kirchberger/WFR-24E_ECU/README.md

# WFR-24E_ECU

In the WFR-24E FSAE car, this device reads all sensor and controls all parts of the WFR-24E.

We decided to have 2 controllers onboared to reduce wiring from front to back of the car.
This significantly reduces the harness complexity in the car.
The car has a 24V low voltage system so the input voltage range of the device must accomadate this, and the device must interface with all sensors and outputs.

Sensors were primarally analog with a few digital buttons.
Motor inverter and BMS were communicated over CAN with a couple lights requiring switched power outputs.
Switched poer is performed with a high side driver.

The final interfaces chosen for the device were:
| Interface | Number |
| :--- | :----- |
| CANBUS | 2 |
| 5V Analog Inputs | 18 |
| 5V IO | 4 |
| 9-36V 3A Switched Power | 8 |
| 5V 0.5A Sensor Supply | 1 |

More analog inputs were chosen for possible expansion of our sensor system.

This device also included reverse voltage protection and a PTC self resetable fuse on the sensor 5V supply.

This was able to be designed with a small sealed form factor based on a Teensy 4.1 for reduced scope.
Box was not included in images.

Image of Assembled Device:

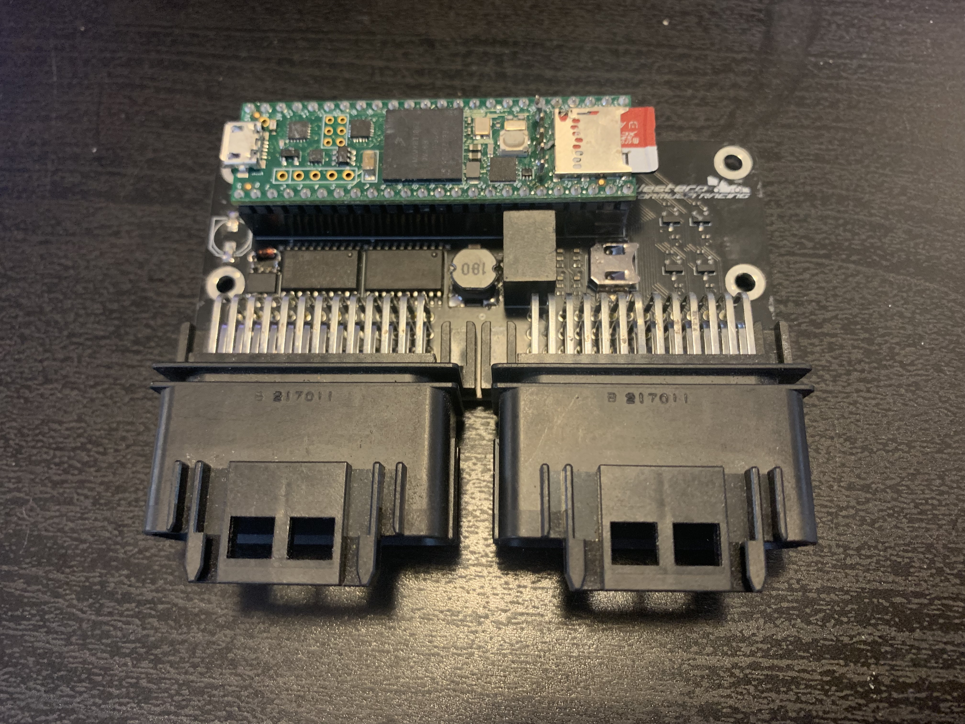
[picture p1: WFR-24E_ECU_Device.jpg]


Image of Inputs Schematic

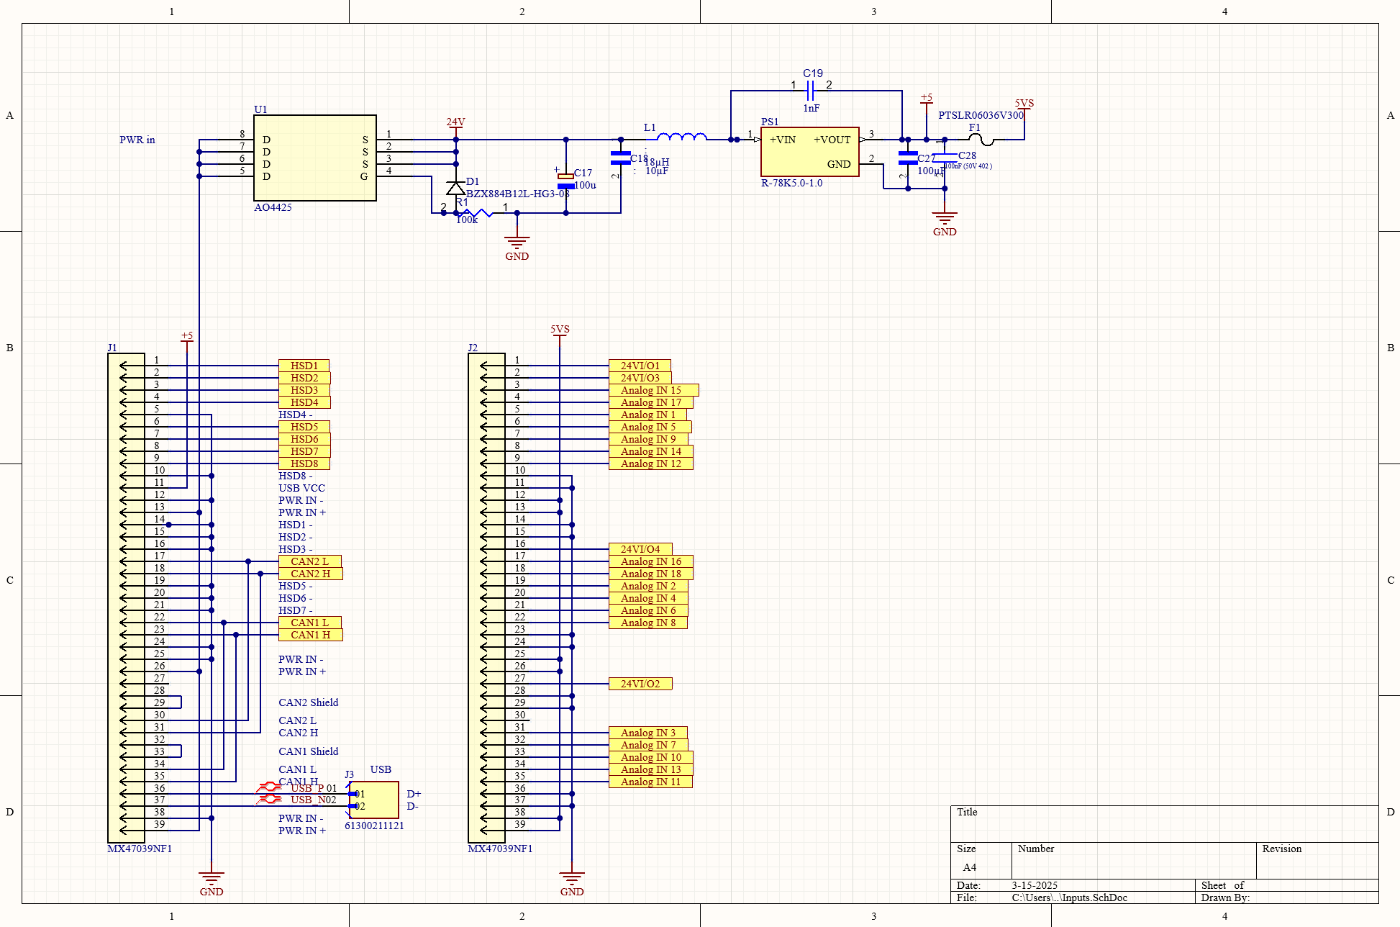
[picture p2: WFR-24E_ECU_Schematic_Inputs.png]
Schematic


Image of Digital and PWR Schematic:

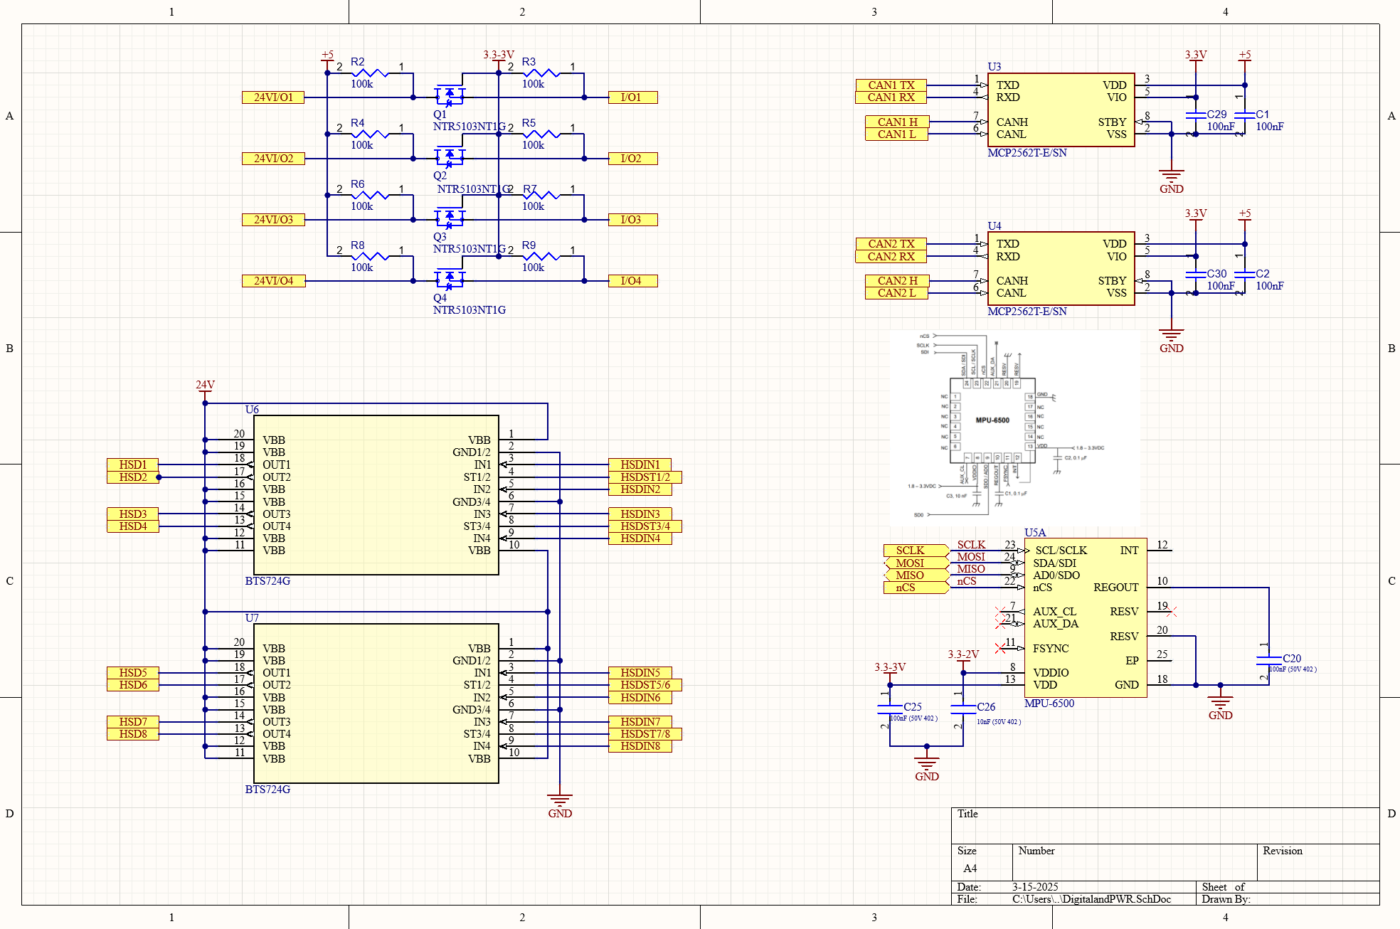
[picture p3: WFR-24E_ECU_Schematic_DigitalandPWR.png]
Schematic


Image of Analog Filtering Schematic:

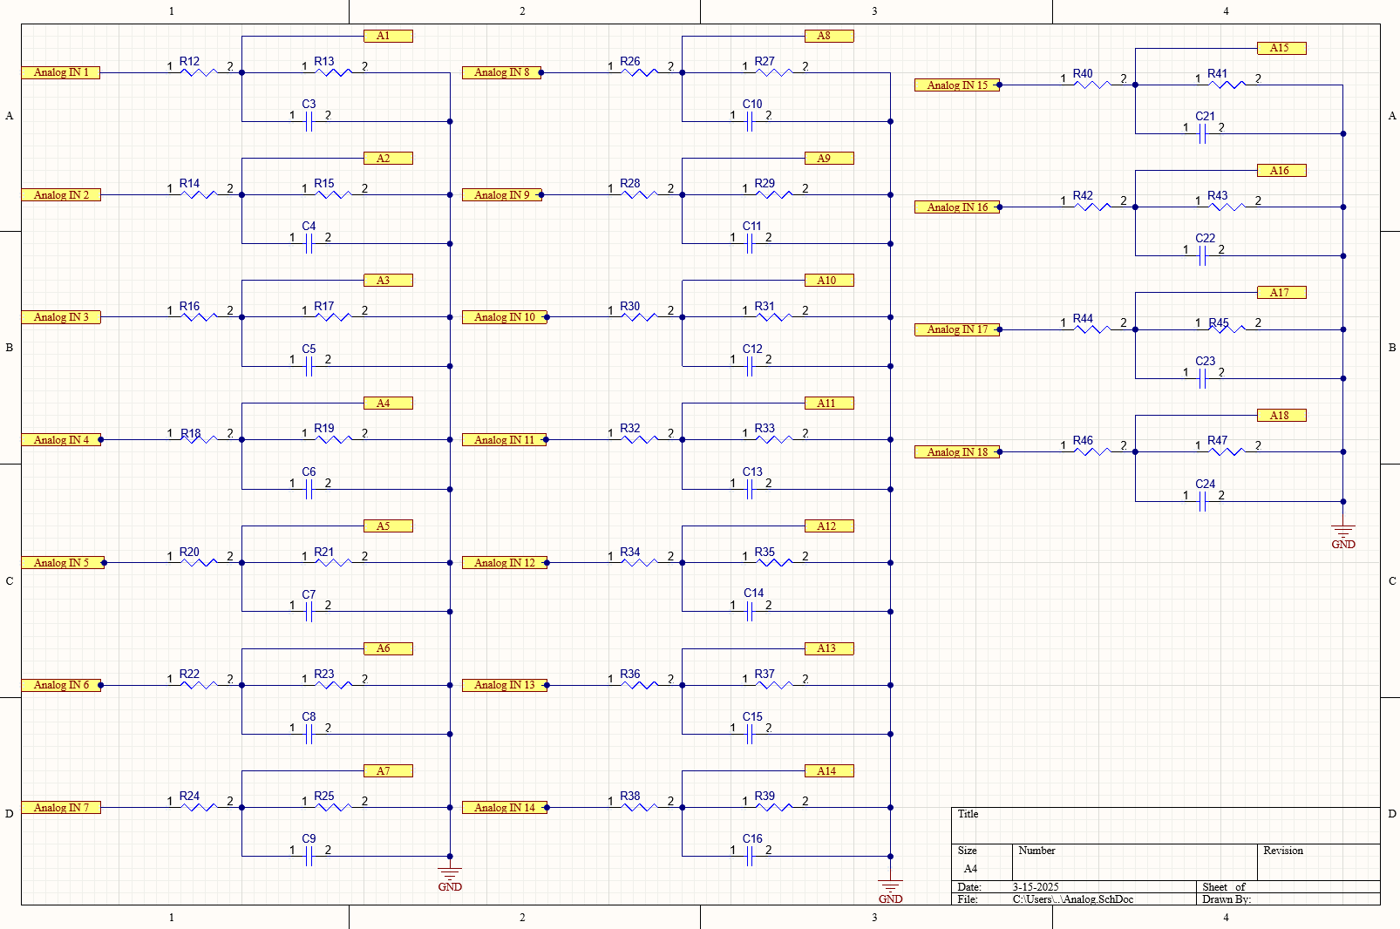
[picture p4: WFR-24E_ECU_Schematic_Analog.png]
Schematic


Image of MCU Schematic:

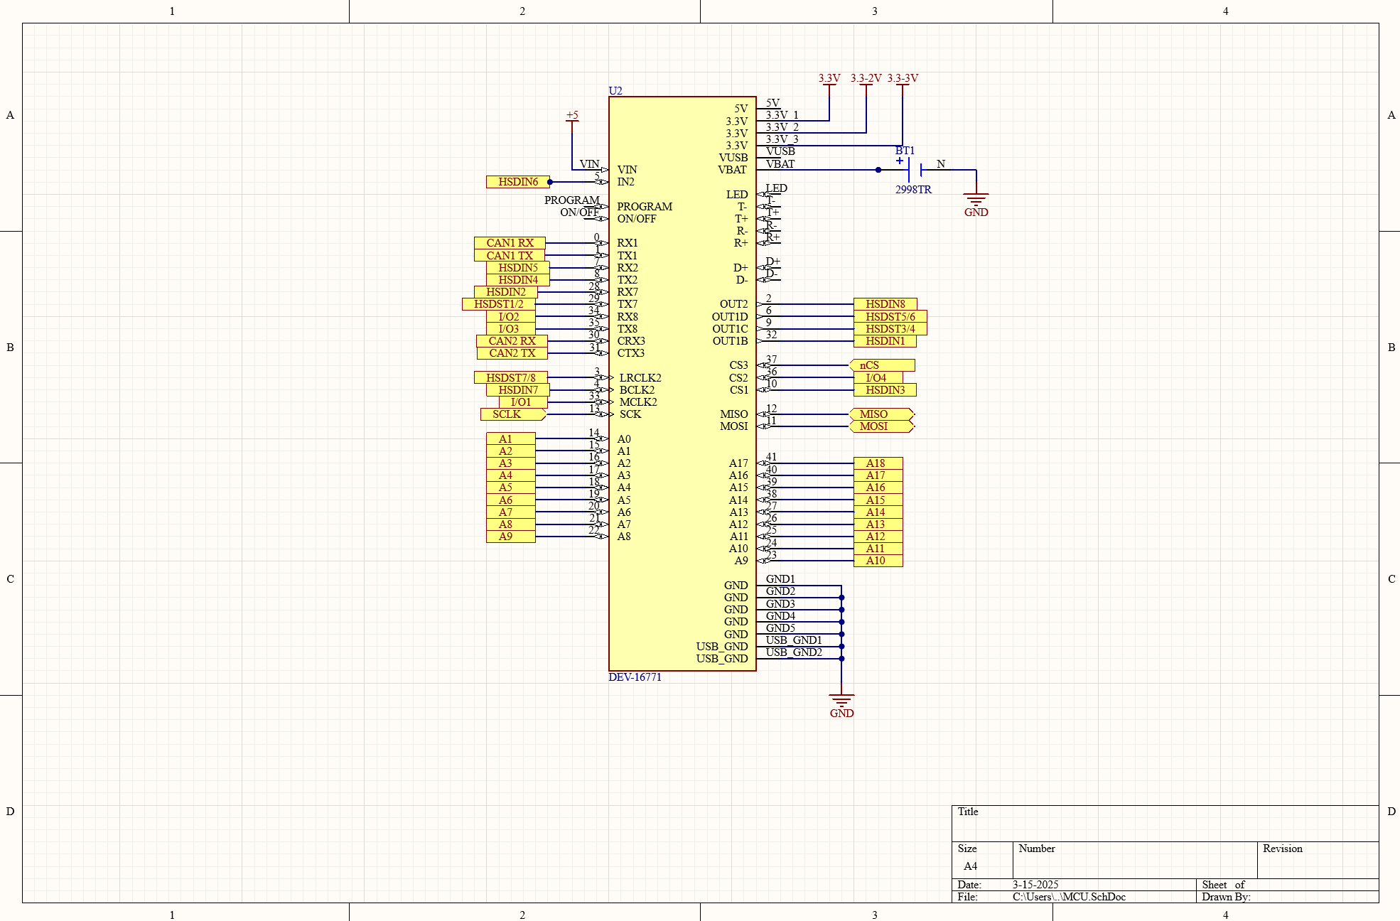
[picture p5: WFR-24E_ECU_Schematic_MCU.png]
Schematic


Image of Model:

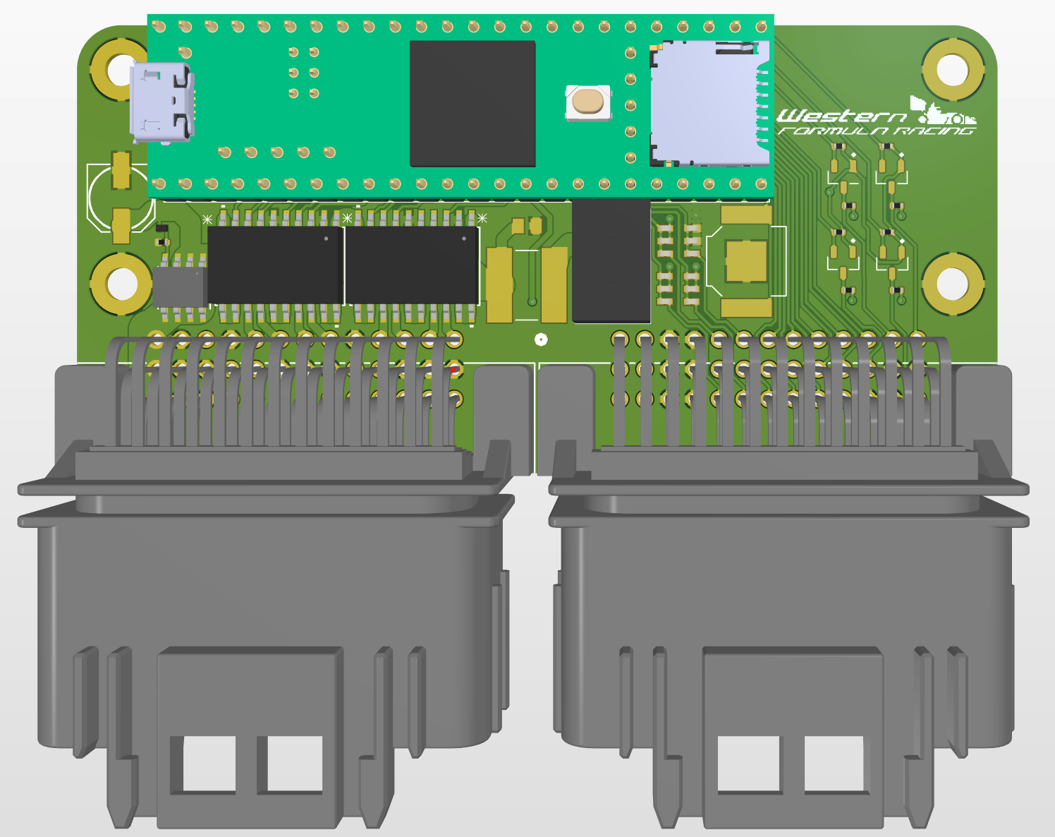
[picture p6: WFR-24E_ECU_Model.png]
