kirchberger/WFR-24E_ECU/WFR24_VCU_BOM_JLCSMT.xlsx

Comment | Designator | Footprint | JLCPCB Part #（optional）
MPU-6500 | U5 | INSE-MPU-6500-QFN24_M | C50278
100nF | C1,C2,C29,C30 | CAPC0402(1005)60_L | C100072
100nF | C20,C25,C28 | FP-CL779-IPC_C | C100072
HSD | U6,U7 | SOIC-20_INF | C82656
CAN Tranceiver | U3,U4 | SOIC127P600X175-8N | C191417
RVP Mosfet | U1 | SO-8_AOS | C2931060
30K resistor | R13,R15,R17,R19,R21,R23,R25,R27,R29,R31,R33,R35,R37,R39,R41,R43,R45,R47 | CAPC1005X04N | C2763772
20K resistor | R12,R14,R16,R18,R20,R22,R24,R26,R28,R30,R32,R34,R36,R38,R40,R42,R44,R46 | CAPC1005X04N | C2766636
100K resistor | R1,R2,R3,R4,R5,R6,R7,R8,R9 | RESC0402(1005)_L | C2984406
MOSFET | Q1,Q2,Q3,Q4 | SOT95P237X111-3N | C152469
10nF | C26 | FP-CL165-IPC_C | C85952
33nF | C3,C4,C5,C6,C7,C8,C9,C10,C11,C12,C13,C14,C15,C16,C21,C22,C23,C24 | CAPC1005X04N | C726517
100uF | C27 | CAPC3216X190N | C883598
1nF | C19 | CAPC0402(1005)33_L | C541372
10uF | C18 | CAPC2012X145N | C440198
