kirchberger/WFR-24E_ECU/(list of files, drawings)

Other design files:
Analog.SchDoc
DigitalandPWR.SchDoc
Inputs.SchDoc
MCU.SchDoc
WFR24_ECU_V1_loc.PrjPcb
